kntkimura/Arduino_DIY_radio_kit/README.md

# Arduino_DIY_radio_kit
Arduino DIY radio kitの組立説明書とソースコード

docs/
    組立説明書と回路図

old/
    旧バージョン情報

src/
    ラジオの制御プログラムのソースコード
