kntkimura/Arduino_DIY_radio_kit/old/NT湘南2025/NT湘南配付基板の訂正.pdf

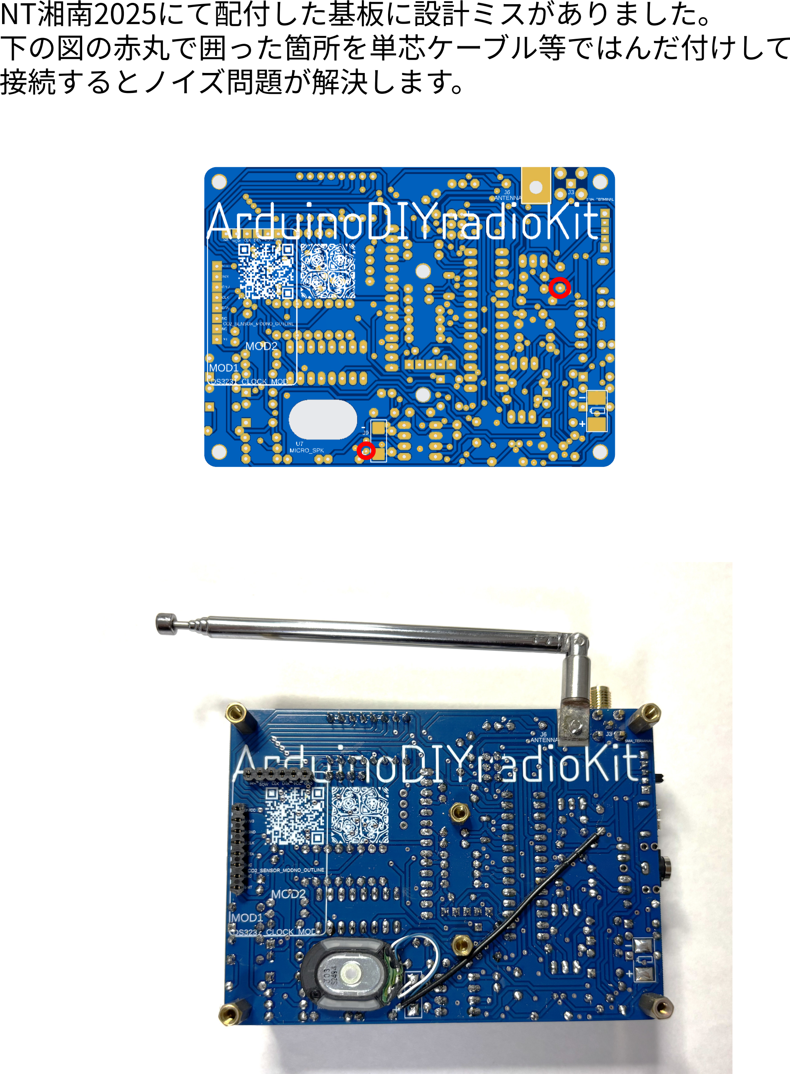
[picture p1: page 1]

NT湘南2025にて配付した基板に設計ミスがありました。 下の図の赤丸で囲った箇所を単芯ケーブル等ではんだ付けして 接続するとノイズ問題が解決します。
