kntkimura/Arduino_DIY_radio_kit/docs/one of two schematics for the Arduino Radio.pdf

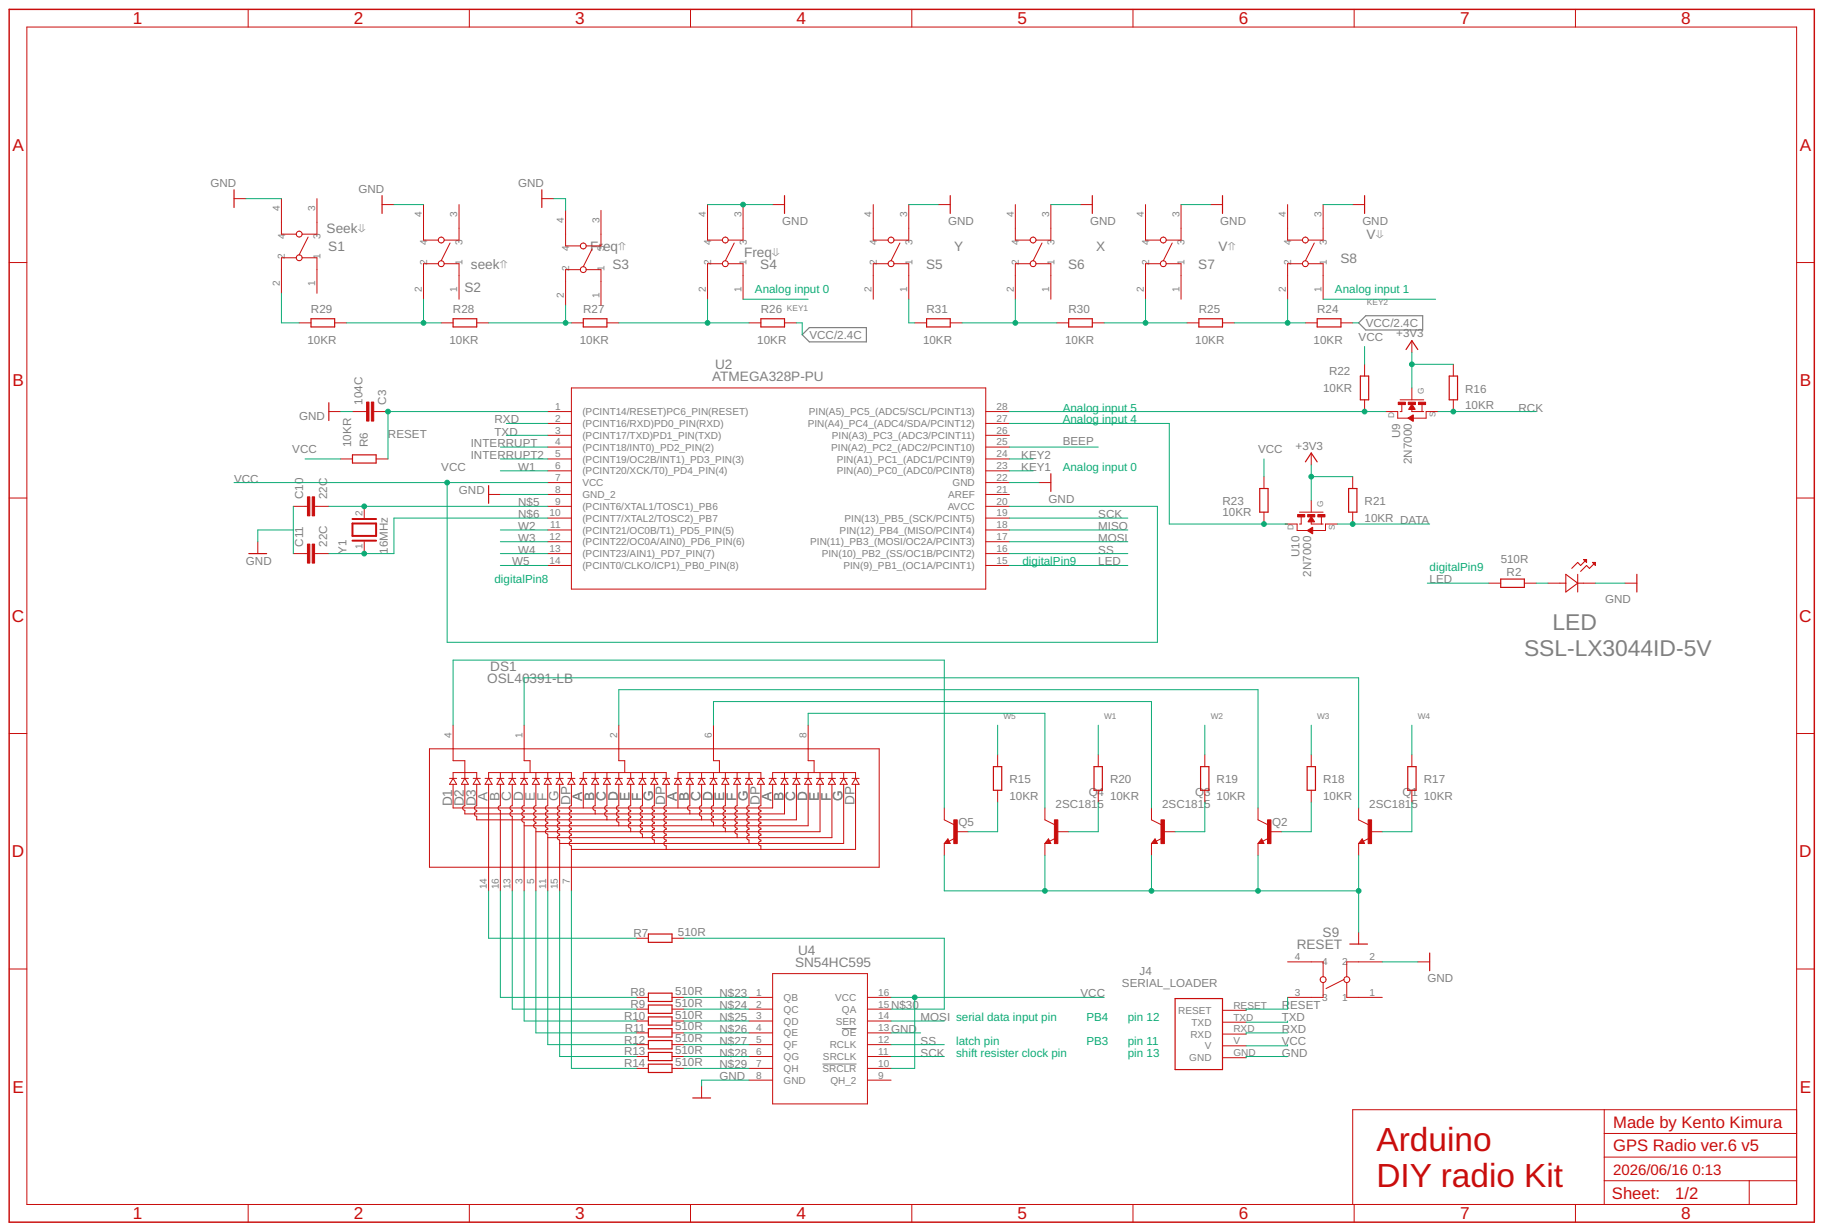
[picture p2: page 1]

Analog input 5 Analog input 4

serial data input pin
latch pin

DIY radio Kit | Made by Kento Kimura Arduino

Sheet: 1/2
