kntkimura/Arduino_DIY_radio_kit/docs/two of two schematics for the Arduino Radio.pdf

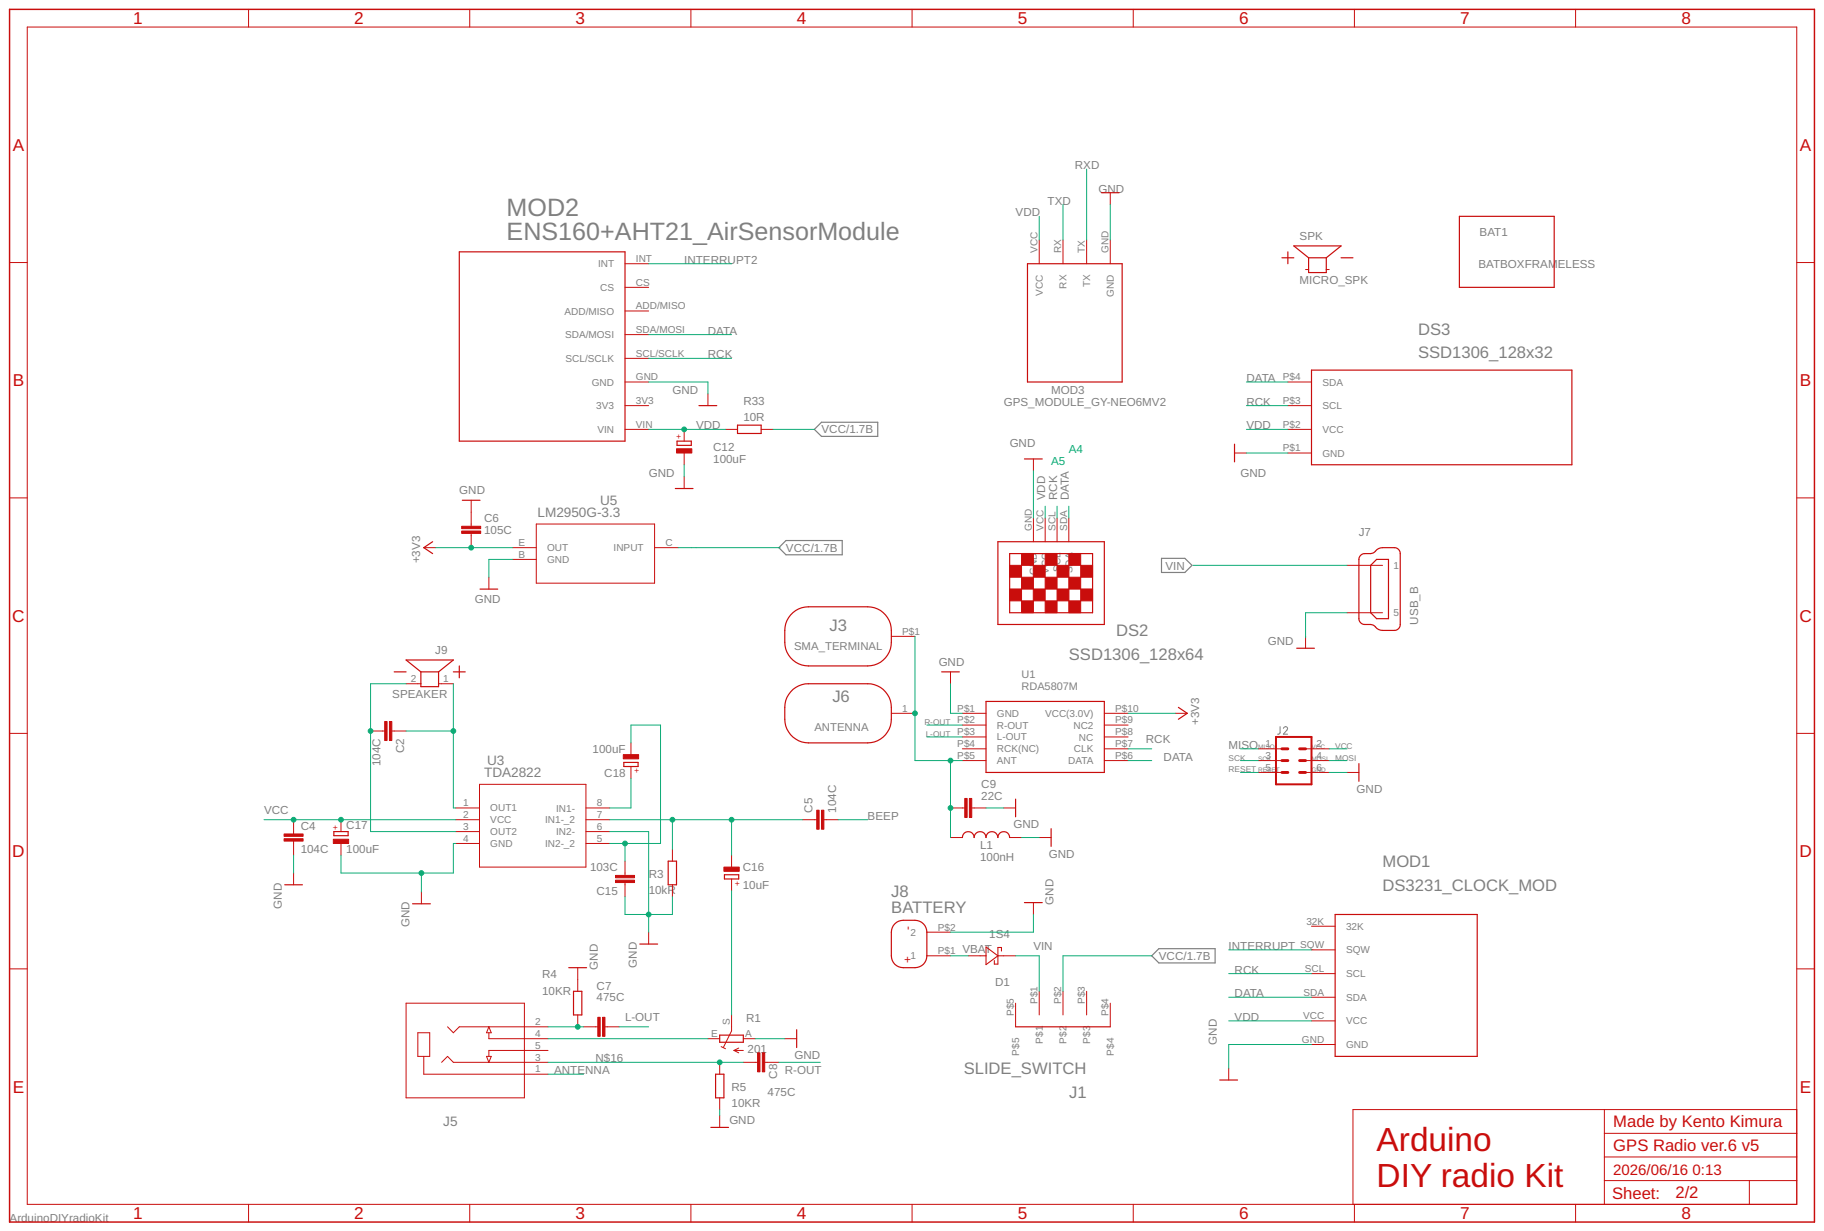
[picture p3: page 1]

DIY radio Kit | Made by Kento Kimura Arduino

Sheet: 2/2
