kntkimura/Arduino_DIY_radio_kit/(commit log)

2025-06-30 Add files via upload
    ラジオとスネークゲームのプログラムを組み合わせました。
    A1,A2ボタン同時押しでモード変更します。
2025-07-01 Add files via upload
    改良版ver.6
2025-10-16 Add files via upload
    8ボタンバージョン用
2025-11-17 Create NT湘南2025
2025-11-17 Create 基板設計ミスの修正法
2025-11-17 Create ノイズ問題の修正法
2025-11-17 Update ノイズ問題の修正法
2025-11-19 Update and rename ノイズ問題の修正法 to ノイズ問題の修正法
2026-06-16 Create READ.me
    ソースコード集
2026-07-01 Create ArduinoRadio_with_the_clock_module
2026-07-04 Update Arduino_Radio.ino
    getbuttonstate()を変更
2026-07-04 Update Arduino_Radio.ino
    コンソールモード時のボタン操作を改善
2026-07-24 Delete docs/the_outline_of_acrylic board.svg
    バージョン更新のために旧バージョンを削除
2026-07-24 Add files via upload
    新バージョンのアクリル板の外形データ
